JithendraHS/Golden_Arduino/README.md

Please check [Golden Arduino](https://github.com/JithendraHS/Golden_Arduino/blob/main/Golden%20Arduino.pdf) report for more information.
