JithendraHS/Golden_Arduino/Jithendra_Golden_Arduino_BOM.xlsx

Comment | Description | Designator | Footprint | LibRef | Quantity | LCSC Part#
LED_RED_1206 | Red 621~631nm 1206 Light Emitting Diodes (LED) RoHS | 3.3V, 5V, LED5, Rx, Tx | LED_1206 | CMP-007-00045-1 | 5 | C93133
C_22uF_1206 | 22uF ±10% 25V X5R 1206 Multilayer Ceramic Capacitors MLCC - SMD/SMT RoHS | C1, C2, C3, C4, C5, C6, C7, C8, C9, C10, C11, C12, C13 | 1206_Passive_Capacitor | CMP-001-00089-1, CMP-001-00098-1 | 13 | C12891
10uF | 10uF ±10% 50V X5R 1206 Multilayer Ceramic Capacitors MLCC - SMD/SMT RoHS | C15 | 1206_Passive_Capacitor | C_10uF_1206 | 1 | C13585
C_1uF_1206 | MULTILAYER CERAMIC CAPACITORS MLCC - SMD/SMT 1UF 50V 1206 ROHS | C16 | 1206_Passive_Capacitor | CMP-001-00095-1 | 1 | C1848
1uF | MULTILAYER CERAMIC CAPACITORS MLCC - SMD/SMT 1UF 50V 1206 ROHS | C17 | 1206_Passive_Capacitor | C_1uF_1206 | 1 | C1848
22uF | 22uF ±10% 25V X5R 1206 Multilayer Ceramic Capacitors MLCC - SMD/SMT RoHS | C18, C19 | 1206_Passive_Capacitor | C_22uF_1206 | 2 | C12891
D_TVS_Diode | TVS SOT-23-6 ROHS | D1 | TVS | CMP-004-00031-1 | 1 | C85364
JM_2_PIN_MALE | 2.54mm Straight 2 1 Header,Breakaway Through Hole,P=2.54mm Pin Header & Female Header ROHS | J1 | 2_PIN_100MIL | CMP-002-00089-1 | 1 | C124375
J_USB_B_Mini | Through Hole USB Connectors RoHS | J2 | USB_MINI_B | CMP-013-000002-1 | 1 | C46398
JF_10_PIN_FEMALE_ | 10 Position Header Connector 0.100" (2.54mm) Through Hole Tin | J4 | 10_PIN_100MIL - Female | CMP-002-00103-1 | 1 | C225507
JF_10_PIN_FEMA_ARDUINO | 10 Position Header Connector 0.100" (2.54mm) Through Hole Tin | J5 | 10_PIN_ARDUINO_100MIL | CMP-002-00102-1 | 1 | C225507
JF_8_PIN_FEMALE | 8 Position Header Connector 0.100" (2.54mm) Through Hole Tin | J6, J8 | 8_PIN_100MIL - Female | CMP-002-00113-1 | 2 | C27438
JF_8_PIN_FEMA_ARD-Pwr | 8 Position Header Connector 0.100" (2.54mm) Through Hole Tin | J7 | 8_PIN_ARD-PWR_100MIL | CMP-002-00112-1 | 1 | C27438
JF_8_PIN_FEMA_ARD-Dig | 8 Position Header Connector 0.100" (2.54mm) Through Hole Tin | J9 | 8_PIN_ARD-DIG_100MIL | CMP-002-00111-1 | 1 | C27438
JF_6_PIN_FEMALE | 6 Position Header Connector 0.100" (2.54mm) Through Hole Tin | J10 | 6_PIN_100MIL -Female | CMP-002-00109-1 | 1 | C40877
JF_6_PIN_FEMA_ARD-Anolog | 6 Position Header Connector 0.100" (2.54mm) Through Hole Tin | J11 | 6_PIN_ARD-Analog_100mil | CMP-002-00108-1 | 1 | C40877
FB_10uH_1206 | 25mA 10uH ±10% 800mO 1206 Inductors (SMD) ROHS | L1 | AIML-1206_ABR-M | CMP-006-00021-1 | 1 | C1051
P_Power Jack | Power Barrel Connector Jack 2.10mm ID (0.083"), 5.50mm OD (0.217") Through Hole, Right Angle | P1 | Power_Jack | CMP-002-00097-1 | 1 | C136744
PS_AMS_LDO_3v3 | LOW DROPOUT REGULATORS(LDO) POSITIVE FIXED 1.3V @ 800MA 15V 3.3V 1A SOT-223 ROHS | PS1 | LDO | CMP-017-000002-1 | 1 | C6186
R_1K_1206 | CHIP RESISTOR - SURFACE MOUNT 1KOHMS ±1% 1/4W 1206 ROHS | R1, R2, R3, R4, R6 | 1206_Passive_Resitor | CMP-009-00194-1 | 5 | C4410
Resistor 10k +/-1% 1206 250 mW | Chip Resistor, 10 KOhm, +/- 1%, 0.25 W, -55 to 155 degC, 1206 (3216 Metric) | R5 | RESC3216X60X45ML15T20 | CMP-009-00016-5 | 1
R_500mOhm_1206 | Resistors/Shunt 250mW 500mO ±800ppm/? ±5% 1206 Current Sense Resistors ROHS | R7 | 1206_Passive_Resitor | CMP-009-00210-1 | 1 | C247433
1M | CHIP RESISTOR - SURFACE MOUNT 1MOHMS ±1% 1/4W 1206 ROHS | R8, R9 | 1206_Passive_Resitor | R_1M_1206 | 2 | C17927
SW_3Pin_100mil_Switch | Connector Header Through Hole 3 position 0.100" (2.54mm) | SW1 | 3_PIN_100mil | CMP-002-00126-1 | 1 | C49257
SW_Push_Button_JLC | Tactile Switch SPST-NO Top Actuated Surface Mount | SW2 | Switch_JLC | CMP-011-00014-1 | 1 | C2837550
TP_10x_Probe | Test Point 300 mil centers | TP_3.3V, TP_5V, TP_D-, TP_D+ | TP10x_Probe | CMP-016-000001-1, CMP-016-000004-1 | 4
TP_Diff_Probe | Test Point 300 mil centers | TP_Curr-, TP_Curr+ | TP_Diff_Probe | CMP-016-000002-1 | 2
U_ATMega328P | AVR AVR® ATmega Microcontroller IC 8-Bit 20MHz 32KB (16K x 16) FLASH 32-TQFP (7x7) | U1 | ATMega328P | CMP-031-00012-1 | 1 | C14877
U_USBtoSerial | Transceiver USB 2.0 2Mbps SOP-16_150mil USB ICs RoHS | U2 | USB to serial | CMP-031-00016-1 | 1 | C14267
X_12MHz_Res | SMD Crystal Resonators 12MHz ±10ppm SMD-3225_4P RoHS | Y1 | Crystal resonator | CMP-003-00030-1 | 1 | C9002
X322516MLB4SI | ±10ppm 16000000Hz -40℃~85℃ 贴片无源晶振 60Ω 9pF SMD3225-4P Crystals ROHS | Y2 | Crystal resonator | X_16Mhz_Res | 1 | C13738
