JithendraHS/Golden_Arduino/(list of files, drawings)

Other design files:
Golden_Arduino.PrjPcb
PCB1.PcbDoc
PCB1_backup.PcbDoc
Sheet1.SchDoc
